tomasf/homepod-mini-wall-mount/Models/Assembly.3mf

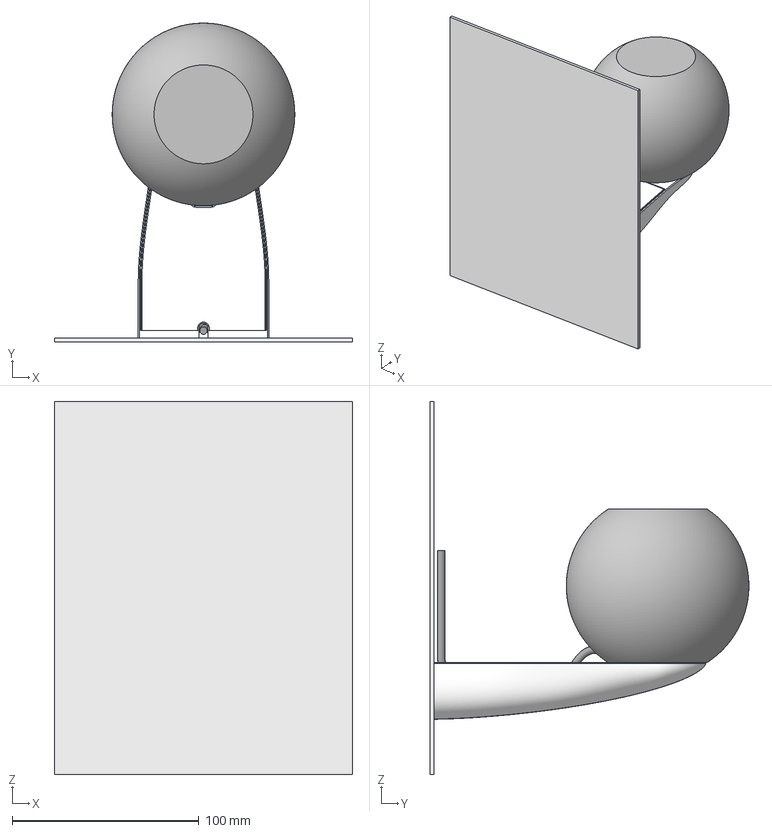
[picture p1: CAD file, 2026-11-04]
Models/Assembly.3mf
160.0 x 170.9 x 200.0 mm
Cable
Coiled cable
HomePod mini
Lid
Wall
