tomasf/homepod-mini-wall-mount/Models/Print plate.3mf

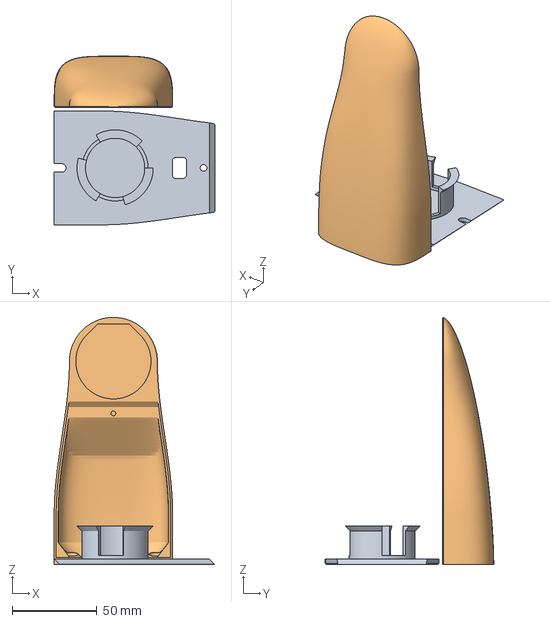
[picture p2: CAD file, 2026-11-04]
Models/Print plate.3mf
94.9 x 99.6 x 145.9 mm
Lid
