tomasf/homepod-mini-wall-mount/(list of files, cad)

Other CAD files:
Print Profile.3mf
